DroneAid-Parts/OpenRX-Lite/README.md

<p align="center">
  DroneAid
</p>

# DroneAid OpenRX Lite

Open-source 2.4 GHz ExpressLRS receiver for small FPV aircraft. DroneAid OpenRX Lite
combines an ESP32-C3 and SX1281 with an on-board ceramic link antenna in a
10.0 x 11.5 mm board.

<p>
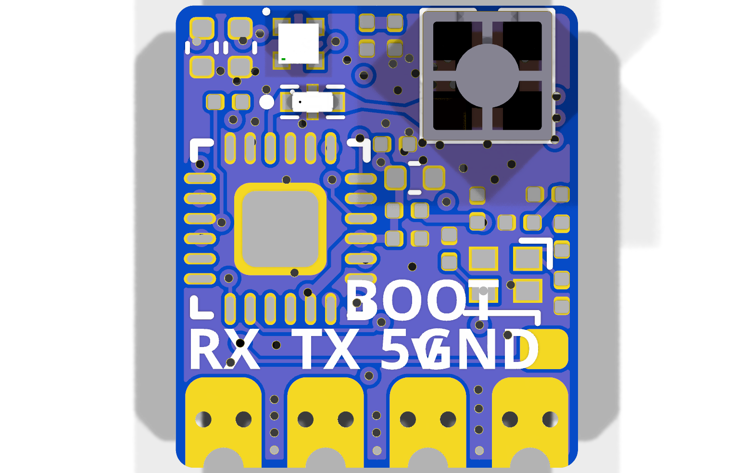
[picture p1: images/front.png]
DroneAid OpenRX Lite front

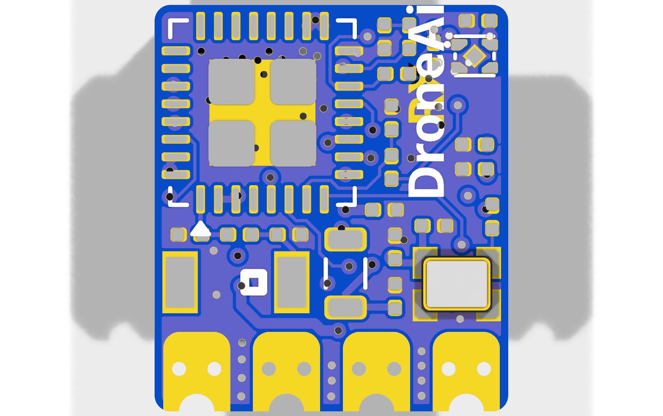
[picture p2: images/back.png]
DroneAid OpenRX Lite back

</p>







## Specifications

| | |
|---|---|
| Band | 2.4 GHz |
| Radio | SX1281 |
| Antenna | On-board ceramic |
| Telemetry power | 13 dBm (20 mW) |
| Protocol | CRSF |
| MCU | ESP32-C3 |
| Input | 5 V pad |
| Firmware | ExpressLRS |
| Flashing | Betaflight passthrough or Wi-Fi |
| Dimensions | 10.0 x 11.5 mm |
| PCB | 6-layer, 1.0 mm |

Technical write-up, part list and layout constraints: [AGENTS.md](AGENTS.md).

## In the line

What pairs with what, and what is available:
[opendrone.be](https://opendrone.be).

## Contributing

See [CONTRIBUTING.md](CONTRIBUTING.md).

## License

Hardware licensed under [CERN-OHL-S-2.0](https://ohwr.org/cern_ohl_s_v2.txt),
see [LICENSE](LICENSE).
