DroneAid-Parts/OpenRX-Lite/hardware/OpenRX-Lite.kicad_pcb

## KiCad design hardware/OpenRX-Lite.kicad_pcb (2026-10-15)

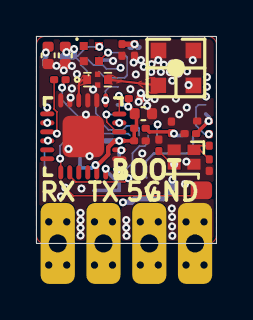
[picture p3: board OpenRX-Lite.kicad_pcb from above]

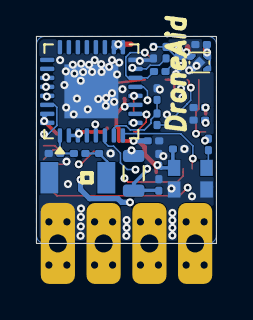
[picture p4: board OpenRX-Lite.kicad_pcb from below]

Board: 6 copper layers, 10.0 x 11.5 mm, 47 parts (22 on the bottom side), 28 nets.

Parts:
AE1: 2450AT18A100E; ANT-SMD_L3.2-W1.6
AE2: 47948-0001; ANT-SMD_47948-0001
C1, C3: 15pF; C_0201_0603Metric
C4, C10, C15, C23, C25, C28: 1uF; C_0201_0603Metric
C5, C6, C9, C12, C13, C14, C17: 100nF; C_0201_0603Metric
C8, C11, C16: 10uF; C_0402_1005Metric
C19: 1nF; C_0201_0603Metric
C20: 470nF; C_0201_0603Metric
C21, C22: 1.2pF; C_0201_0603Metric
C24, C26, C27: 10nF; C_0201_0603Metric
D1: XL-1010RGBC-WS2812B; LED-SMD_4P-L1.0-W1.0-TL_XL-1010RGBC-WS2812B
FL1: 2450FM07D0034T; FILTER-SMD_4P-L1.0-W0.5-L
L1: 24nH; L_0201_0603Metric
L2: 2.5nH; L_0201_0603Metric
L3: 2.0nH; L_0201_0603Metric
L4: 15uH; L_0805_2012Metric
OSC1: OW7EL89CENUNFAYLC-52M; OSC-SMD_4P-L2.0-W1.6-BL_TXC_7Z
R2, R3, R4, R5: 10k; R_0201_0603Metric
TP1: RX; SolderPad_1.2x2.0mm
TP2: TX; SolderPad_1.2x2.0mm
TP3: 5V; SolderPad_1.2x2.0mm
TP4: GND; SolderPad_1.2x2.0mm
TP5: BOOT; SolderPad_1.2x2.0mm
U1: ESP32-C3; QFN-32-1EP_5x5mm_P0.5mm_EP3.7x3.7mm
U2: TLV75533PDQNR; X2SON-4_L1.0-W1.0-P0.65-TL-EP
U3: SX1281IMLTRT; QFN-24_L4.0-W4.0-P0.50-TL-EP2.6
X1: CJ17-400001010B20; CRYSTAL-SMD_4P-L1.6-W1.2-BL

Connections:
+3V3: C4.1, C5.1, C6.1, C9.1, C11.1, C12.1, C13.1, C14.1, C15.1, C16.1, C17.1, C23.1, C24.1, D1.2 (VDD), L3.2, OSC1.4 (VDD), R2.1, R3.1, R4.1, R5.2, U1.11 (VDD3P3_RTC), U1.17 (VDD3P3_CPU), U1.18 (VDD_SPI), U1.31 (VDDA), U1.32 (VDDA), U2.1 (OUT), U3.11 (VBAT_IO), U3.15 (VBAT)
+5V: C8.1, C10.1, TP3.1 (1_1), U2.3 (EN), U2.4 (IN)
/ESP32-C3 + SX1281 Core (UFL)/BOOT: R4.2, TP5.1 (1_1), U1.15 (GPIO9)
/ESP32-C3 + SX1281 Core (UFL)/BUSY: U1.8 (GPIO3), U3.7 (BUSY)
/ESP32-C3 + SX1281 Core (UFL)/CHIP_EN: C28.1, R5.1, U1.7 (CHIP_EN)
/ESP32-C3 + SX1281 Core (UFL)/DIO1: U1.5 (XTAL_32K_N), U3.8 (DIO1)
/ESP32-C3 + SX1281 Core (UFL)/LED: D1.4 (DIN), R3.2, U1.14 (GPIO8)
/ESP32-C3 + SX1281 Core (UFL)/MISO: U1.10 (MTDI), U3.16 (MISO_TX)
/ESP32-C3 + SX1281 Core (UFL)/MOSI: U1.9 (MTMS), U3.17 (MOSI_RX)
/ESP32-C3 + SX1281 Core (UFL)/NSS: U1.13 (MTDO), U3.19 (NSS_CTS)
/ESP32-C3 + SX1281 Core (UFL)/RST: R2.2, U1.6 (GPIO2), U3.3 (NRESET)
/ESP32-C3 + SX1281 Core (UFL)/SCK: U1.12 (MTCK), U3.18 (SCK_RTSN)
/ESP32-C3 + SX1281 Core (UFL)/WIFI: AE1.1, C21.1, L2.1
/ESP32-C3 + SX1281 Core (UFL)/XTAL_N: C3.1, U1.29 (XTAL_N), X1.3
/ESP32-C3 + SX1281 Core (UFL)/XTAL_P: L1.2, U1.30 (XTAL_P)
GND: AE2.1, AE2.2, AE2.4, C1.2, C3.2, C4.2, C5.2, C6.2, C8.2, C9.2, C10.2, C11.2, C12.2, C13.2, C14.2, C15.2, C16.2, C17.2, C20.1, C21.2, C22.2, C23.2, C24.2, C25.2, C26.1, C27.2, C28.2, D1.3 (GND), FL1.2 (GND), FL1.4 (GND), OSC1.1 (GND), OSC1.2 (GND), TP4.1 (1_1), U1.16 (GPIO10), U1.33 (GND), U2.2 (GND), U2.5 (EP), U3.13 (GND), U3.20 (GND), U3.21 (GND), U3.23 (GND), U3.24 (GND), U3.25 (EP), X1.2 (GND), X1.4 (GND)
unnamed: C1.1, L1.1, X1.1
unnamed: C25.1, L3.1, U1.2 (VDD3P3), U1.3 (VDD3P3)
unnamed: FL1.1 (IN), U3.22 (RFIO)
unnamed: AE2.3, FL1.3 (OUT)
unnamed: C19.1, OSC1.3 (Out_Put)
unnamed: C22.1, L2.2, U1.1 (LNA_IN)
unnamed: TP1.1 (1_1), U1.27 (U0RXD)
unnamed: TP2.1 (1_1), U1.28 (U0TXD)
unnamed: C20.2, C26.2, L4.1, U3.2 (VDD_IN), U3.12 (DCC_FB)
unnamed: L4.2, U3.14 (DCC_SW)
unnamed: C27.1, U3.1 (VR_PA)
unnamed: C19.2, U3.4 (XTA)
