DroneAid-Parts/OpenRX-Lite/(commit log)

2026-10-12 docs(agents): cut AGENTS.md to validate, boundaries, pointers (#5)
    AGENTS.md 160 -> 18 lines. Removes architecture, tables, procedures and
    state; keeps only hard boundaries and the validation command.
    Claude-Session: https://claude.ai/code/session_017Ye54fa9v5VP179Xbw465R
2026-10-13 docs: restore AGENTS.md technical write-up (#7)
    Reverts the AGENTS.md cut and the README pointer change; the write-up is board documentation, not duplicated elsewhere.
    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
2026-10-15 Apply DroneAid rebrand and configure upstream sync
    [OpenRX-Lite.kicad_pcb]
